josevasquez123/SLEEP-OASIS-PUERTA-PCB/Puerta.kicad_pcb

## KiCad design Puerta.kicad_pcb (2024-02-19)

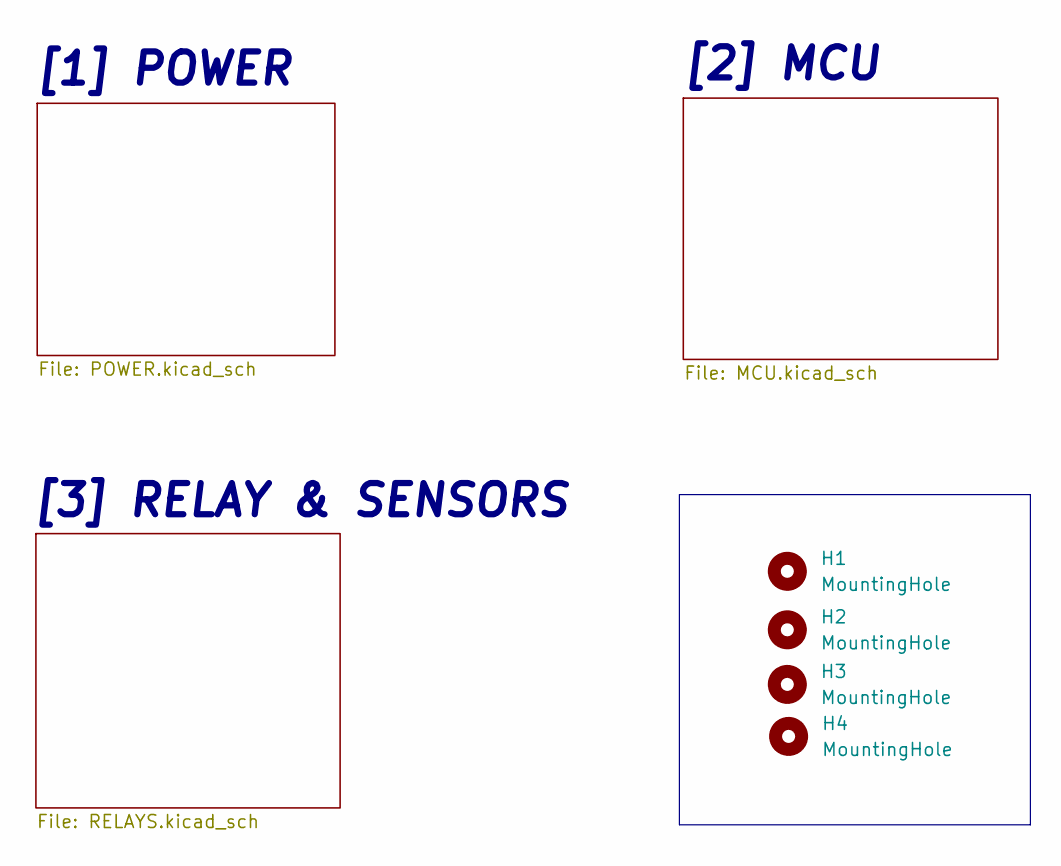
[picture p1: schematic Puerta.kicad_sch]

Parts:
H1, H2, H3, H4: MountingHole; MountingHole_3.2mm_M3

Notes on the sheet:
[1] POWER
[3] RELAY & SENSORS
[2] MCU

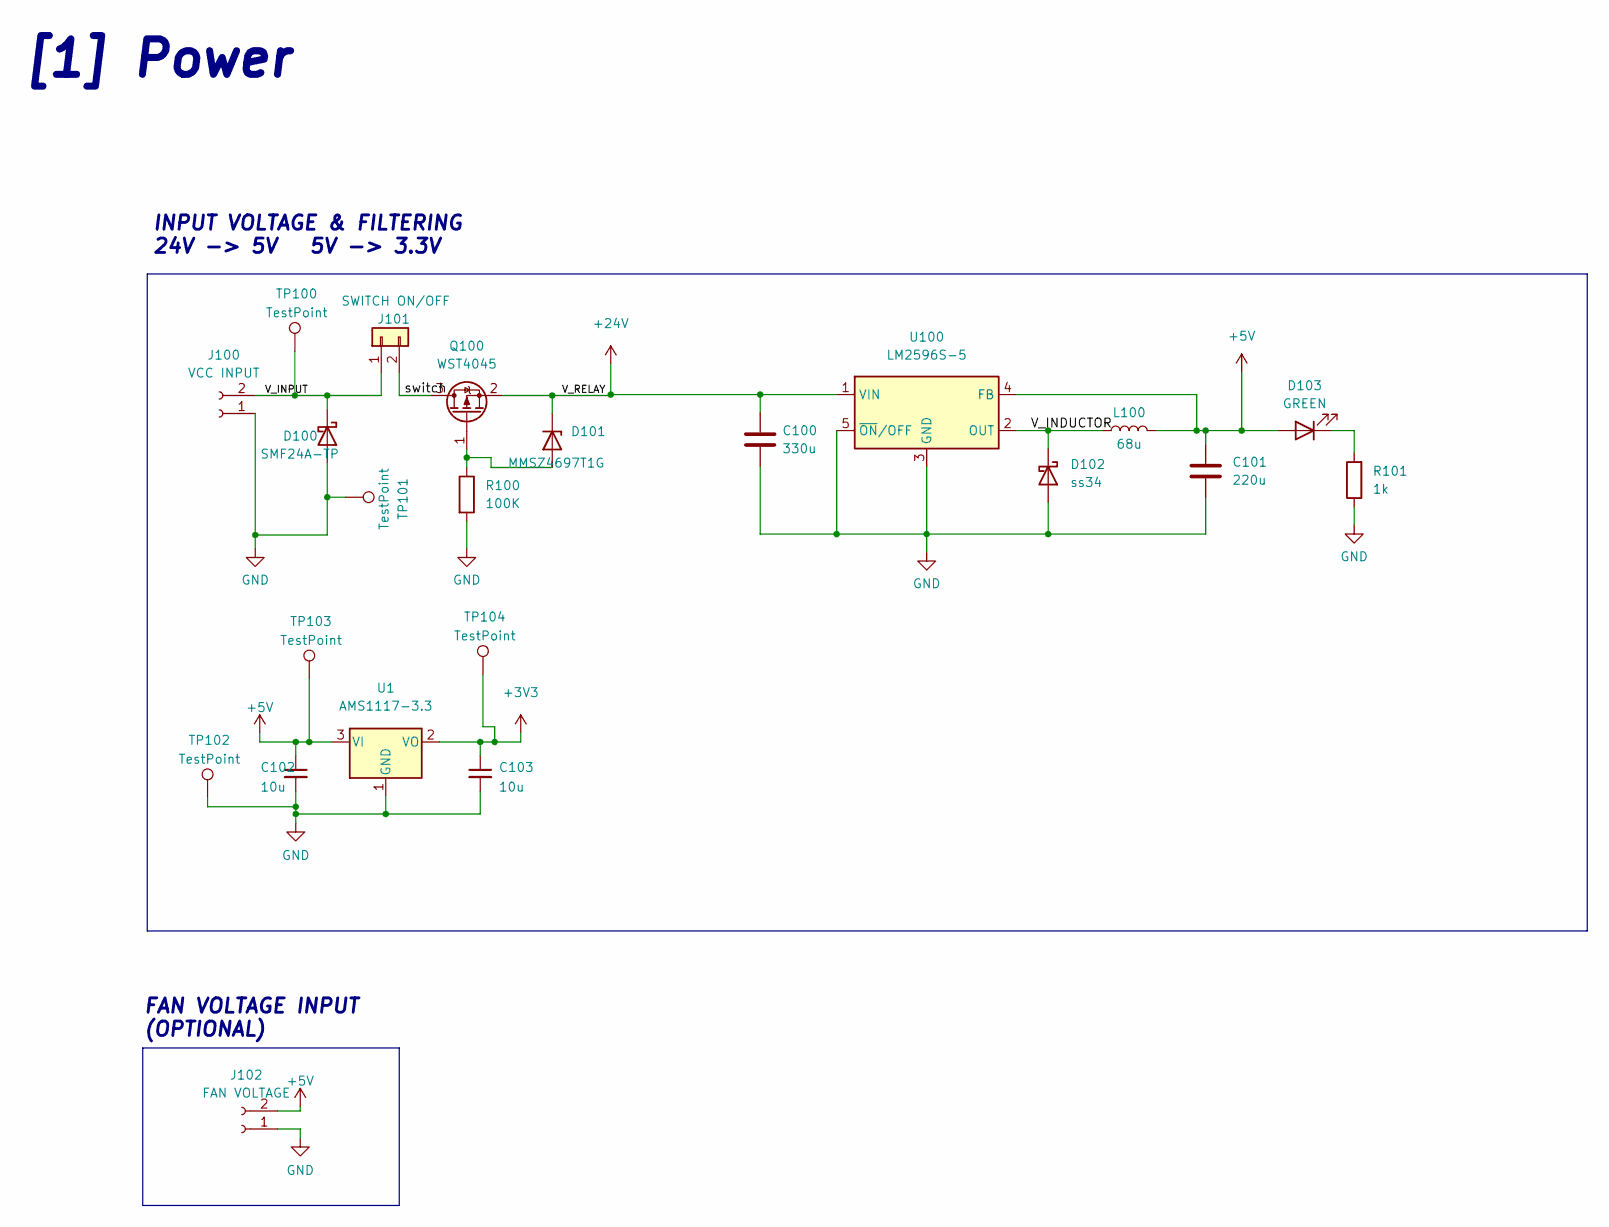
[picture p2: schematic POWER.kicad_sch]

Parts:
C100: 330u; C_Elec_10x10.2; LCSC C239324
C101: 220u; CP_Elec_10x10.5; LCSC C2886113
C102, C103: 10u; C_0805_2012Metric; LCSC C15850
D100: SMF24A-TP; SOD_123FL; LCSC C545276
D101: MMSZ4697T1G; D_SOD-123; LCSC C48870
D102: ss34; D_SMA; LCSC C8678
D103: GREEN; LED_0603_1608Metric; LCSC C72043
J100: VCC INPUT; PhoenixContact_MSTBA_2,5_2-G-5,08_1x02_P5.08mm_Horizontal
J101: SWITCH ON/OFF; JST_B2B-XH-A_LF__SN_
J102: FAN VOLTAGE; PinHeader_1x02_P2.54mm_Vertical
L100: 68u; L_12.3x12.3; LCSC C2929504
Q100: WST4045; SOT-23; LCSC C719073
R100: 100K; R_1206_3216Metric; LCSC C17900
R101: 1k; R_0603_1608Metric; LCSC C21190
TP100, TP101, TP102, TP103, TP104: TestPoint; TestPoint_Pad_D2.0mm
U1: AMS1117-3.3; SOT-223-3_TabPin2; LCSC C6186
U100: LM2596S-5; TO-263-5_TabPin3

Connections:
+5V: C101.1, C102.1, D103.2 (A), J102.2, L100.2, TP103.1, U1.3 (VI), U100.4 (FB); also elsewhere on the board
+24V: C100.1, D101.1 (K), Q100.2 (S), U100.1 (VIN); also elsewhere on the board
/POWER/V_INDUCTOR: D102.1 (K), L100.1, U100.2 (OUT)
/POWER/V_INPUT: D100.1 (K), J100.2, J101.1, TP100.1
/POWER/switch: J101.2, Q100.3 (D)
GND: C100.2, C101.2, C102.2, C103.2, D100.2 (A), D102.2 (A), J100.1, J102.1, R100.2, R101.1, TP101.1, TP102.1, U1.1 (GND), U100.3 (GND), U100.5 (~ON/OFF); also elsewhere on the board
unnamed: D101.2 (A), Q100.1 (G), R100.1
unnamed: D103.1 (K), R101.2

Notes on the sheet:
INPUT VOLTAGE & FILTERING 24V -> 5V 5V -> 3.3V
FAN VOLTAGE INPUT (OPTIONAL)
[1] Power

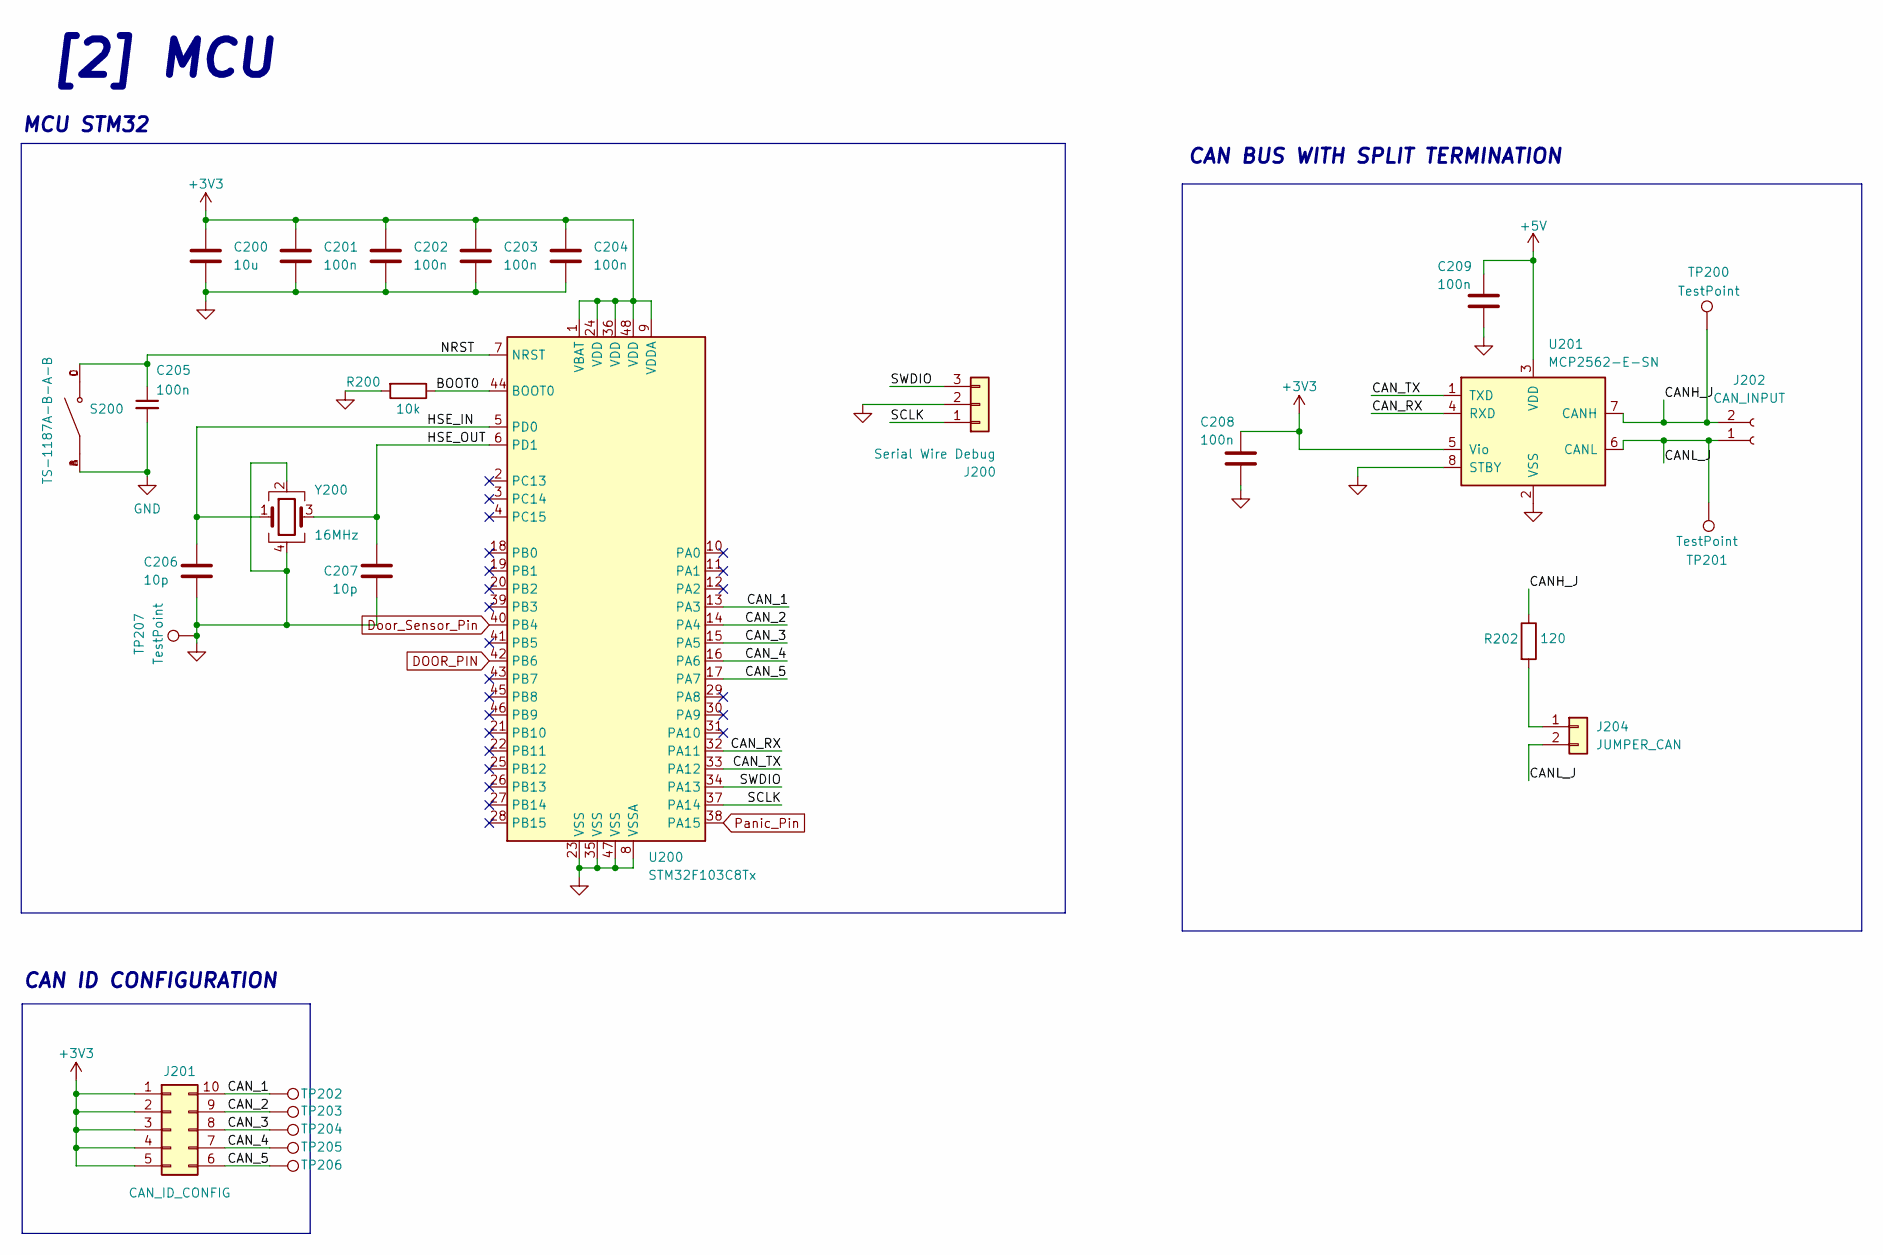
[picture p3: schematic MCU.kicad_sch]

Parts:
C200: 10u; C_0603_1608Metric; LCSC C19702
C201, C202, C203, C204, C205, C208, C209: 100n; C_0402_1005Metric; LCSC C1525
C206, C207: 10p; C_0402_1005Metric; LCSC C32949
J200: Serial Wire Debug; PinSocket_1x03_P2.54mm_Vertical
J201: CAN_ID_CONFIG; SW_DIP_SPSTx05_Slide_9.78x14.88mm_W7.62mm_P2.54mm
J202: CAN_INPUT; PhoenixContact_MSTBA_2,5_2-G-5,08_1x02_P5.08mm_Horizontal
J204: JUMPER_CAN; PinHeader_1x02_P2.54mm_Vertical
R200: 10k; R_0402_1005Metric; LCSC C25744
R202: 120; R_0805_2012Metric; LCSC C17437
S200: TS-1187A-B-A-B; SWITCH_SMD; LCSC C318884
TP200, TP201, TP202, TP203, TP204, TP205, TP206, TP207: TestPoint; TestPoint_Pad_D2.0mm
U200: STM32F103C8Tx; LQFP-48_7x7mm_P0.5mm
U201: MCP2562-E-SN; SOIC-8_3.9x4.9mm_P1.27mm; LCSC C191417
Y200: 16MHz; Crystal_SMD_3225-4Pin_3.2x2.5mm; LCSC C13738

Connections:
+5V: C209.1, U201.3 (VDD); also elsewhere on the board
/MCU/BOOT0: R200.1, U200.44 (BOOT0)
/MCU/CANH_J: J202.2, R202.1, TP200.1, U201.7 (CANH)
/MCU/CANL_J: J202.1, J204.2, TP201.1, U201.6 (CANL)
/MCU/CAN_1: J201.10, TP202.1, U200.13 (PA3)
/MCU/CAN_2: J201.9, TP203.1, U200.14 (PA4)
/MCU/CAN_3: J201.8, TP204.1, U200.15 (PA5)
/MCU/CAN_4: J201.7, TP205.1, U200.16 (PA6)
/MCU/CAN_5: J201.6, TP206.1, U200.17 (PA7)
/MCU/CAN_RX: U200.32 (PA11), U201.4 (RXD)
/MCU/CAN_TX: U200.33 (PA12), U201.1 (TXD)
/MCU/HSE_IN: C206.1, U200.5 (PD0), Y200.1
/MCU/HSE_OUT: C207.1, U200.6 (PD1), Y200.3
/MCU/NRST: C205.1, S200.C, S200.D, U200.7 (NRST)
/MCU/SCLK: J200.1, U200.37 (PA14)
/MCU/SWDIO: J200.3, U200.34 (PA13)
DOOR_PIN: U200.42 (PB6); also elsewhere on the board
Door_Sensor_Pin: U200.40 (PB4); also elsewhere on the board
GND: C200.2, C201.2, C202.2, C203.2, C204.2, C205.2, C206.2, C207.2, C208.2, C209.2, J200.2, R200.2, S200.A, S200.B, TP207.1, U200.8 (VSSA), U200.23 (VSS), U200.35 (VSS), U200.47 (VSS), U201.2 (VSS), U201.8 (STBY), Y200.2, Y200.4; also elsewhere on the board
unnamed: J204.1, R202.2
Panic_Pin: U200.38 (PA15); also elsewhere on the board

Notes on the sheet:
[2] MCU
MCU STM32
CAN ID CONFIGURATION
CAN BUS WITH SPLIT TERMINATION

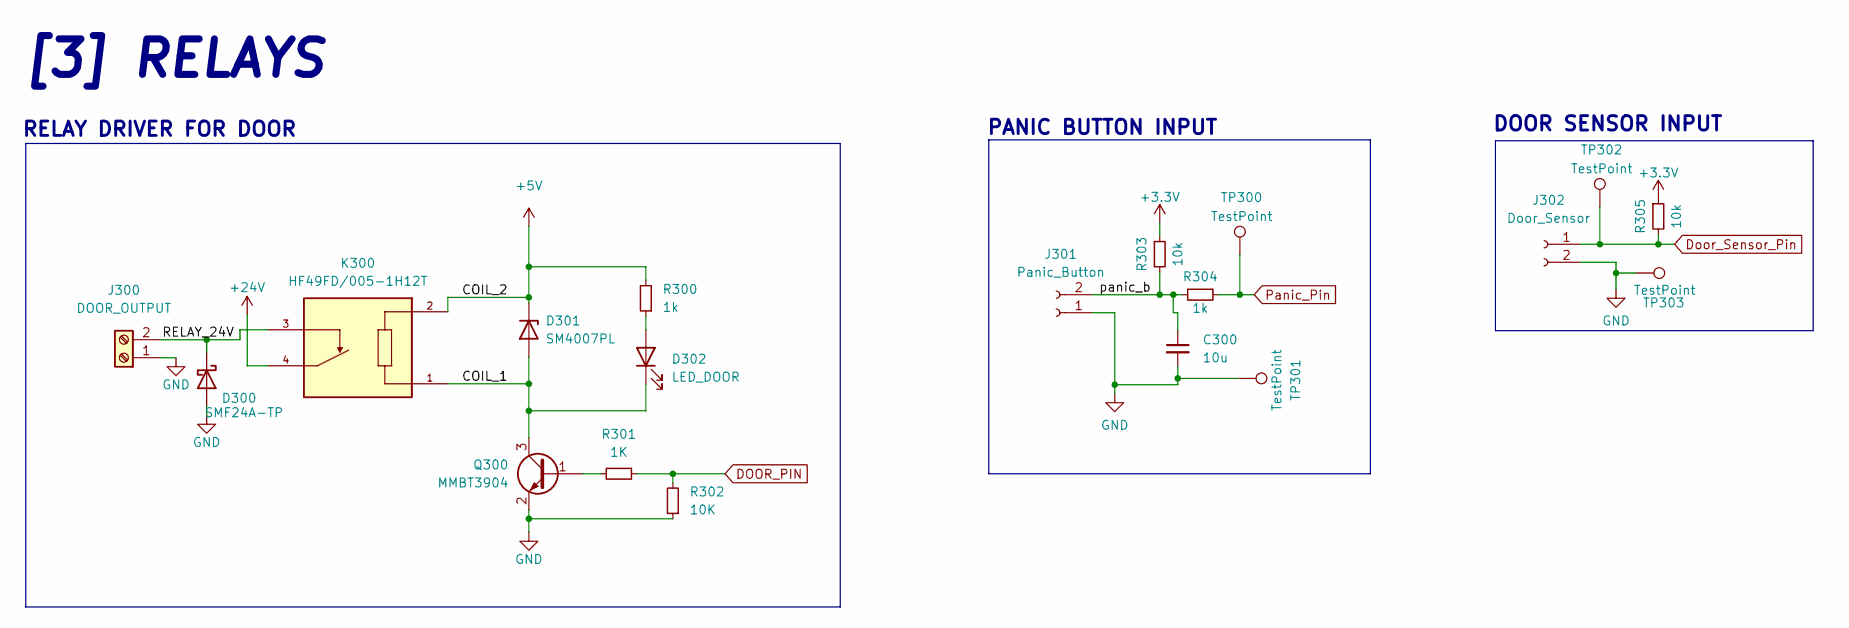
[picture p4: schematic RELAYS.kicad_sch]

Parts:
C300: 10u; C_0603_1608Metric; LCSC C19702
D300: SMF24A-TP; SOD_123FL; LCSC C545276
D301: SM4007PL; SOD_123FL; LCSC C64898
D302: LED_DOOR; LED_0603_1608Metric; LCSC C72038
J300: DOOR_OUTPUT; PhoenixContact_MSTBA_2,5_2-G-5,08_1x02_P5.08mm_Horizontal
J301: Panic_Button; PhoenixContact_MSTBA_2,5_2-G-5,08_1x02_P5.08mm_Horizontal
J302: Door_Sensor; PhoenixContact_MSTBA_2,5_2-G-5,08_1x02_P5.08mm_Horizontal
K300: HF49FD/005-1H12T; HF49FD0051H11F; PARTREV 1.13
Q300: MMBT3904; SOT-23; LCSC C20526
R300, R304: 1k; R_0603_1608Metric; LCSC C21190
R301: 1K; R_0603_1608Metric; LCSC C21190
R302: 10K; R_0603_1608Metric; LCSC C25804
R303, R305: 10k; R_0603_1608Metric; LCSC C25804
TP300, TP301, TP302, TP303: TestPoint; TestPoint_Pad_D2.0mm

Connections:
+5V: D301.1 (K), K300.2, R300.2; also elsewhere on the board
+24V: K300.4; also elsewhere on the board
/RELAYS&INPUTS/COIL_1: D301.2 (A), D302.1 (K), K300.1, Q300.3 (C)
/RELAYS&INPUTS/RELAY_24V: D300.1 (K), J300.2, K300.3
/RELAYS&INPUTS/panic_b: C300.1, J301.2, R303.2, R304.2
DOOR_PIN: R301.1, R302.2; also elsewhere on the board
Door_Sensor_Pin: J302.1, R305.2, TP302.1; also elsewhere on the board
GND: C300.2, D300.2 (A), J300.1, J301.1, J302.2, Q300.2 (E), R302.1, TP301.1, TP303.1; also elsewhere on the board
unnamed: D302.2 (A), R300.1
unnamed: Q300.1 (B), R301.2
Panic_Pin: R304.1, TP300.1; also elsewhere on the board

Notes on the sheet:
DOOR SENSOR INPUT
PANIC BUTTON INPUT
[3] RELAYS
RELAY DRIVER FOR DOOR

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
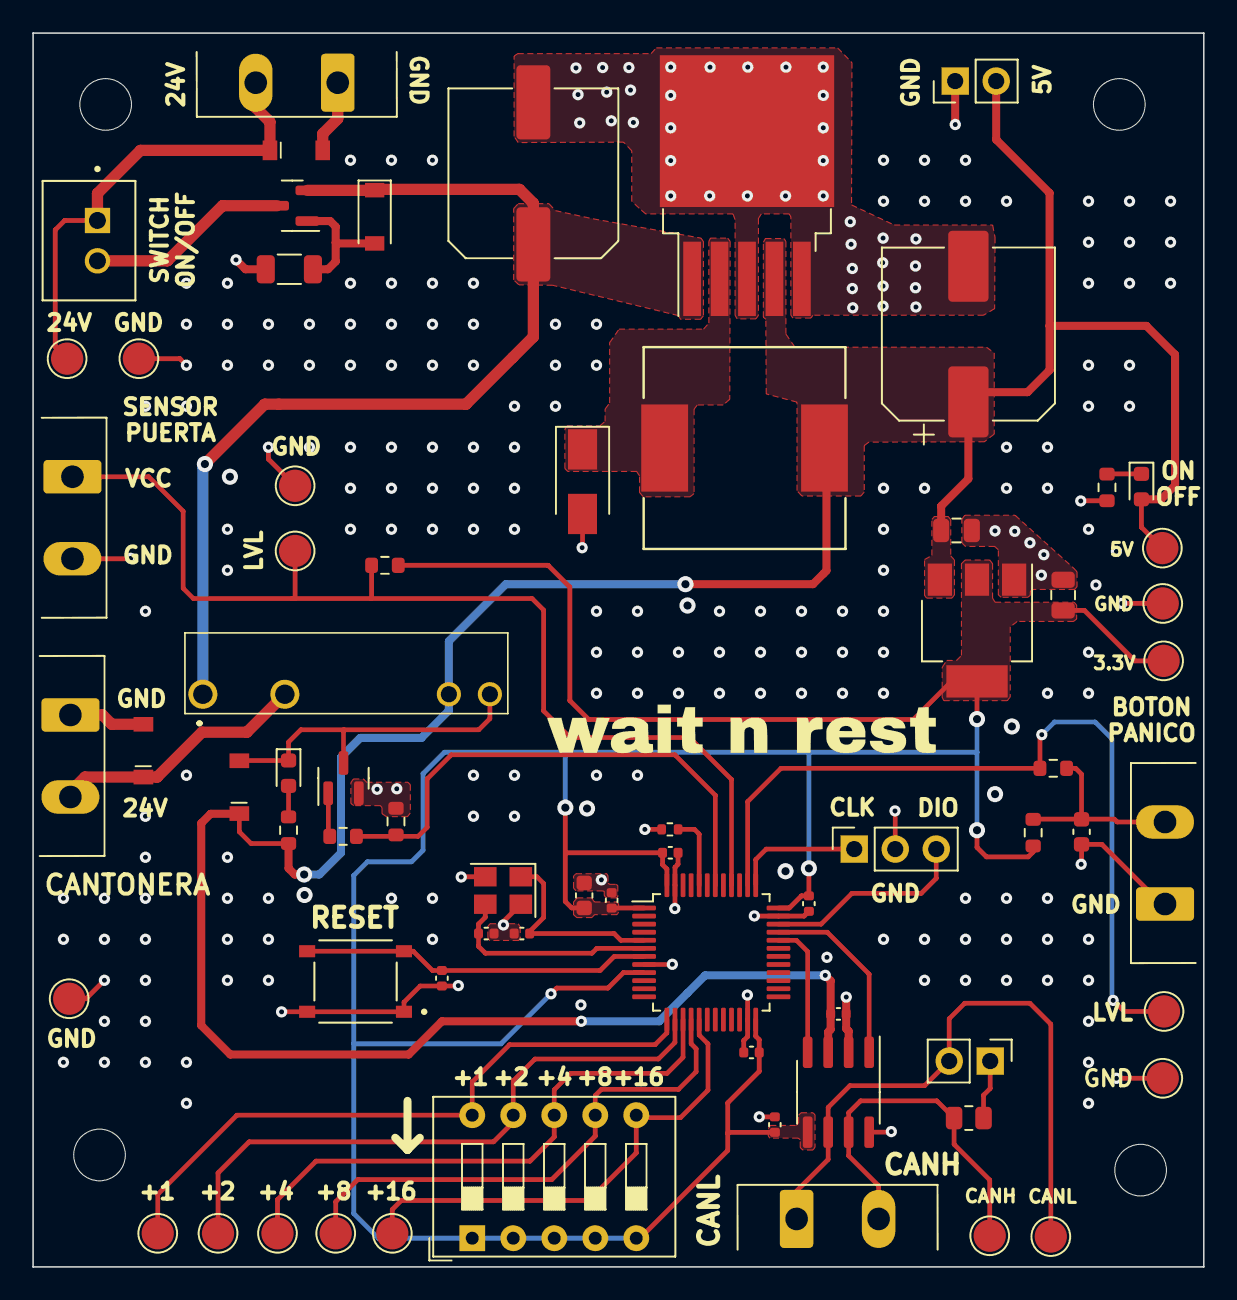
[picture p5: board Puerta.kicad_pcb from above]

Board: 4 copper layers, 72.5 x 76.4 mm, 73 parts (0 on the bottom side), 33 nets.
