josevasquez123/SLEEP-OASIS-PUERTA-PCB/(commit log)

2023-12-11 added logo
    [Puerta.kicad_pcb]
2023-12-21 change board stackup and added logo
    [Puerta.kicad_pcb, bom.csv, designators.csv, positions.csv]
2024-02-19 version validada
    [MCU.kicad_sch, POWER.kicad_sch, Puerta.kicad_pcb, Puerta.kicad_sch, RELAYS.kicad_sch, bom.csv, designators.csv, positions.csv]
